sashaml29/arduino-remote-gsm-station/README.md

# arduino-remote-gsm-station

основной модуль построен на Arduino Mega 2560
датчики на основе Arduino Uno, но не плата а чипы AtMega328P 
проект  умеет :

считывать данные с беспроводных датчиков с длительным временем работы

выводить их на дисплей

посылать по команде информацию с датчиков по смс по номеру первой ячейки сим

записывать в первую ячейку мастер номер и в дальнейшем реагировать на команды только с этого номера

на определенные датчики при превышении или уменьшении некого порога посылается смс сообщение

на sd карту должен ведется лог показаний датчиков

датчик - все удаленное устройство целиком, к нему подключены сенсоры (температуры, влажности и т. д.)
датчики имеют номера с 0 до 9 (0 - это головной блок), сенсоры имеют номера с 0 до 9.

команды смс :

#info - краткая информация с датчиков

#inff - полная информация с датчиков -напряжение батареи и время прихода последних данных

#settime -установка текущего времени в модуль часов, время берется автоматически из служебных данных смс

#setmynum -установка мастер номера, с которого будут приниматься команды, с других номеров игнорироваться

#balans посылка текущего балнса

#all - вывести список всех уведомлений

#al*  - удалить все уведомления

#al1* удалить уведомление с заданным номером, где 1 - номер ячейки в массиве уведомлений

#al123u34.50 - в ячейку 1 от датчика 2 , а его сенсора 3 , u -признак того что увкедомление будет послано при превышении порга, d - при понижении порога, 34.50  сам порог срабатывания сенсора,

эти команды могут быть даны с последовательного порта (консоли)

Данные датчиков пишуться в лог с именем файла (номер датчика) и расширением csv и разделителем точка с запятой. 
На каждый датчик два лога 1.csv и t1.csv , в лог 1.csv пишутся данные только при изменнении данных каких либо сенсоров датчика, в t1 - регулярно каждый час.
Вывести лог можно в косоль командой:

log 1 или

log t1 , вместо 1 - номер датчика

dellog 1 удаляет лог файл 1.csv

С консоли можно ввести команду для модема, если команда консоли начинается с AT, то  она будет отправлена в модем, ответ модема будет выведен в консоль. 

команда консоли listmd выводит в консоль основной массив данных датчиков

проект должен еще уметь 

вести системный лог - рестарты, пропадание сигнала с датчиков

выводить на экран несколько страниц показаний, листание- кнопкой

посылать смс при при пропадании питания

посылать смс при перезагрузке, если это была аварийная презагрузка

считывать показания датчиков, подключенных к основной плате

должна быть возможность подключится из интернета по wifi и посмотреть текущие показания

должна быть возможность прочитать лог датчиков с интернета

должна быть возможность включать внешние устройства по команде с смс или по показаниям датчиков

исходный код
https://create.arduino.cc/editor/sasha_ml/d271f25d-d158-4372-87bb-69d778120403/preview

схемы
https://easyeda.com/sasha_ml/Arduino_Mega-15a761a8028f4398b58b41b1c01d44cf
https://easyeda.com/normal/with_sim900-cec6111705ad414b99fb65d70da5dad2
