sashaml29/arduino-remote-gsm-station/rf433modules/Readme.md

В этой папке рабочий проект с приемником с дисплеем 1602 на Ardiuino Uno и передатчиком на atmega328P вставленной в колодку программатора.

В приемнике используется дешевый модуль приемника 433 мгц

В передатчике используются два датчика dht22, 18ds20, пердатчик на батарейках, исрользованы энергосберегающие режимы

схемы
https://easyeda.com/sasha_ml/arduino_with_lcd_and_rfmodule-15622ccd768a4618abc1057a1459d12f

recivtestlowpower.ino	приемник на батарейках, сбор данных с радиомодулей и передача на narodmon через esp8266
