sashaml29/arduino-remote-gsm-station/rf433modules/Reciv.png

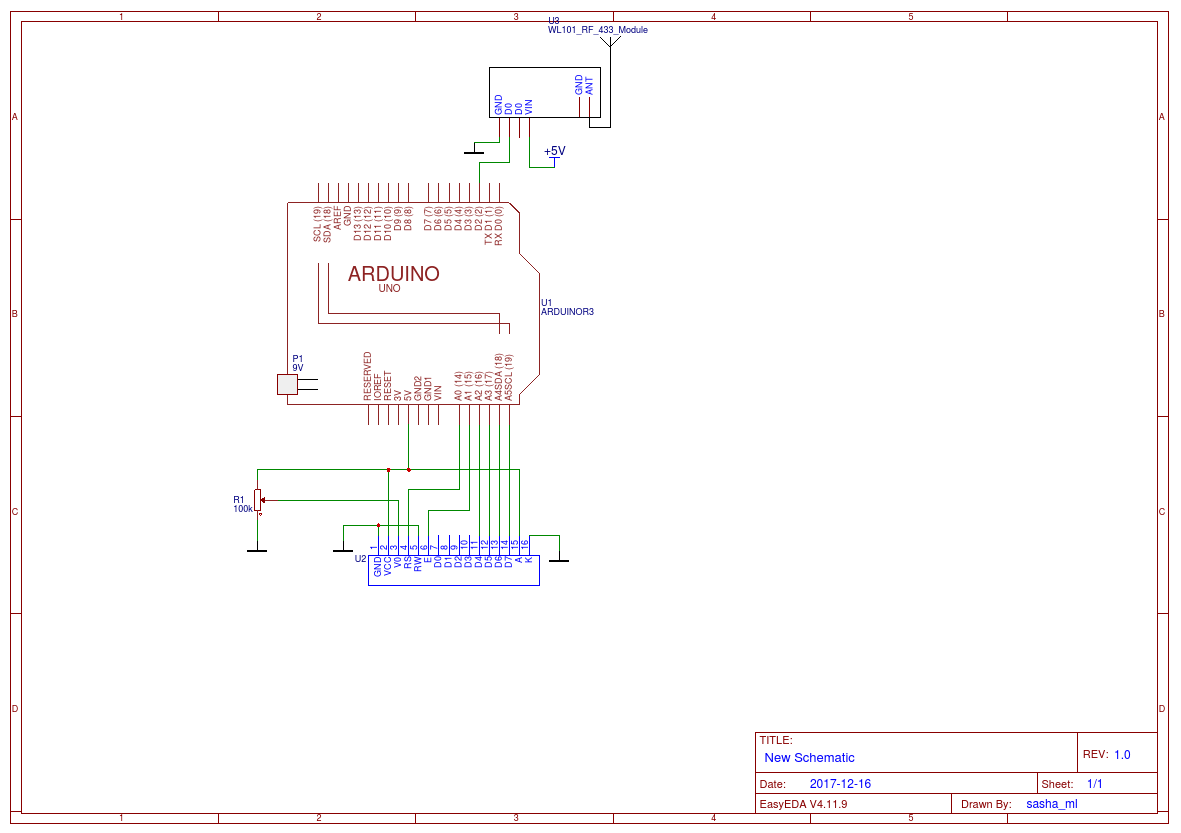
rf433modules/Reciv.png
