sashaml29/arduino-remote-gsm-station/rf433modules/transmitter433.png

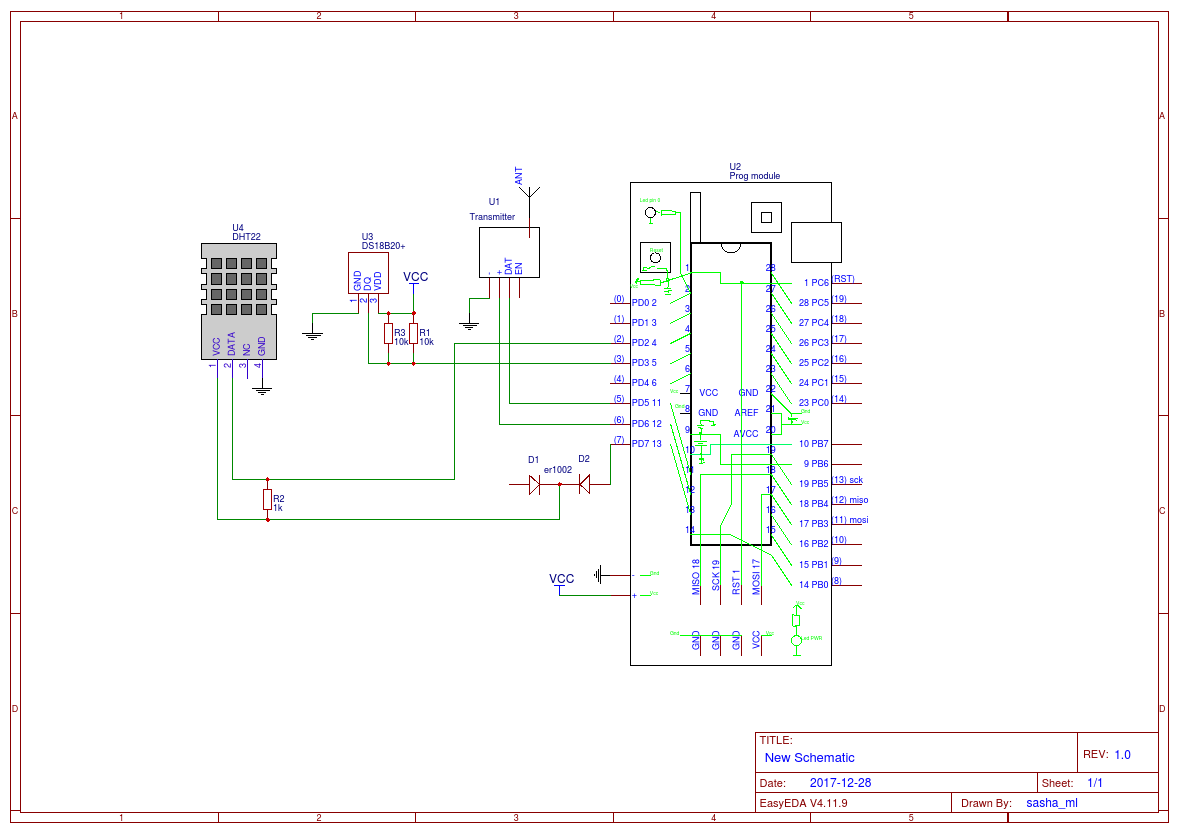
rf433modules/transmitter433.png
