sashaml29/arduino-remote-gsm-station/rf433modules/transmitter.pdf

## VCC

## testmode (if connect to GND)

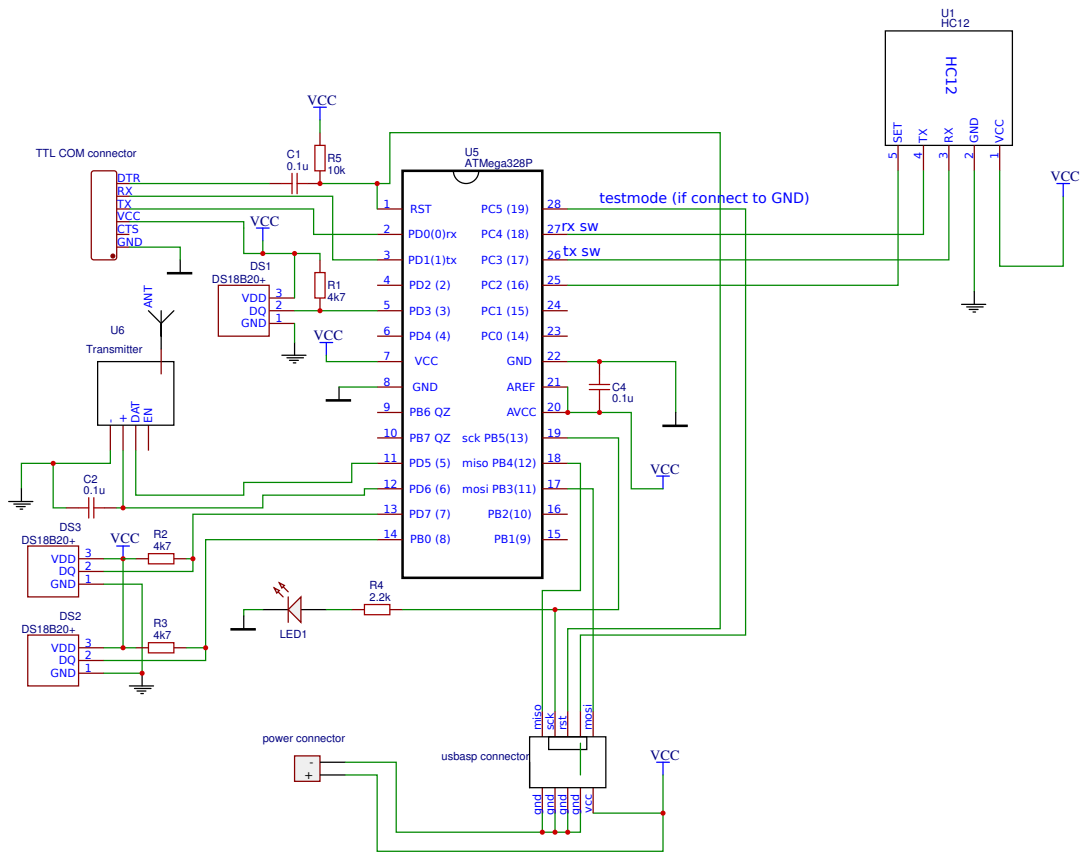
[picture p3: page 1]
