sashaml29/arduino-remote-gsm-station/rf433modules/recivtestlowpower.pdf

## Text

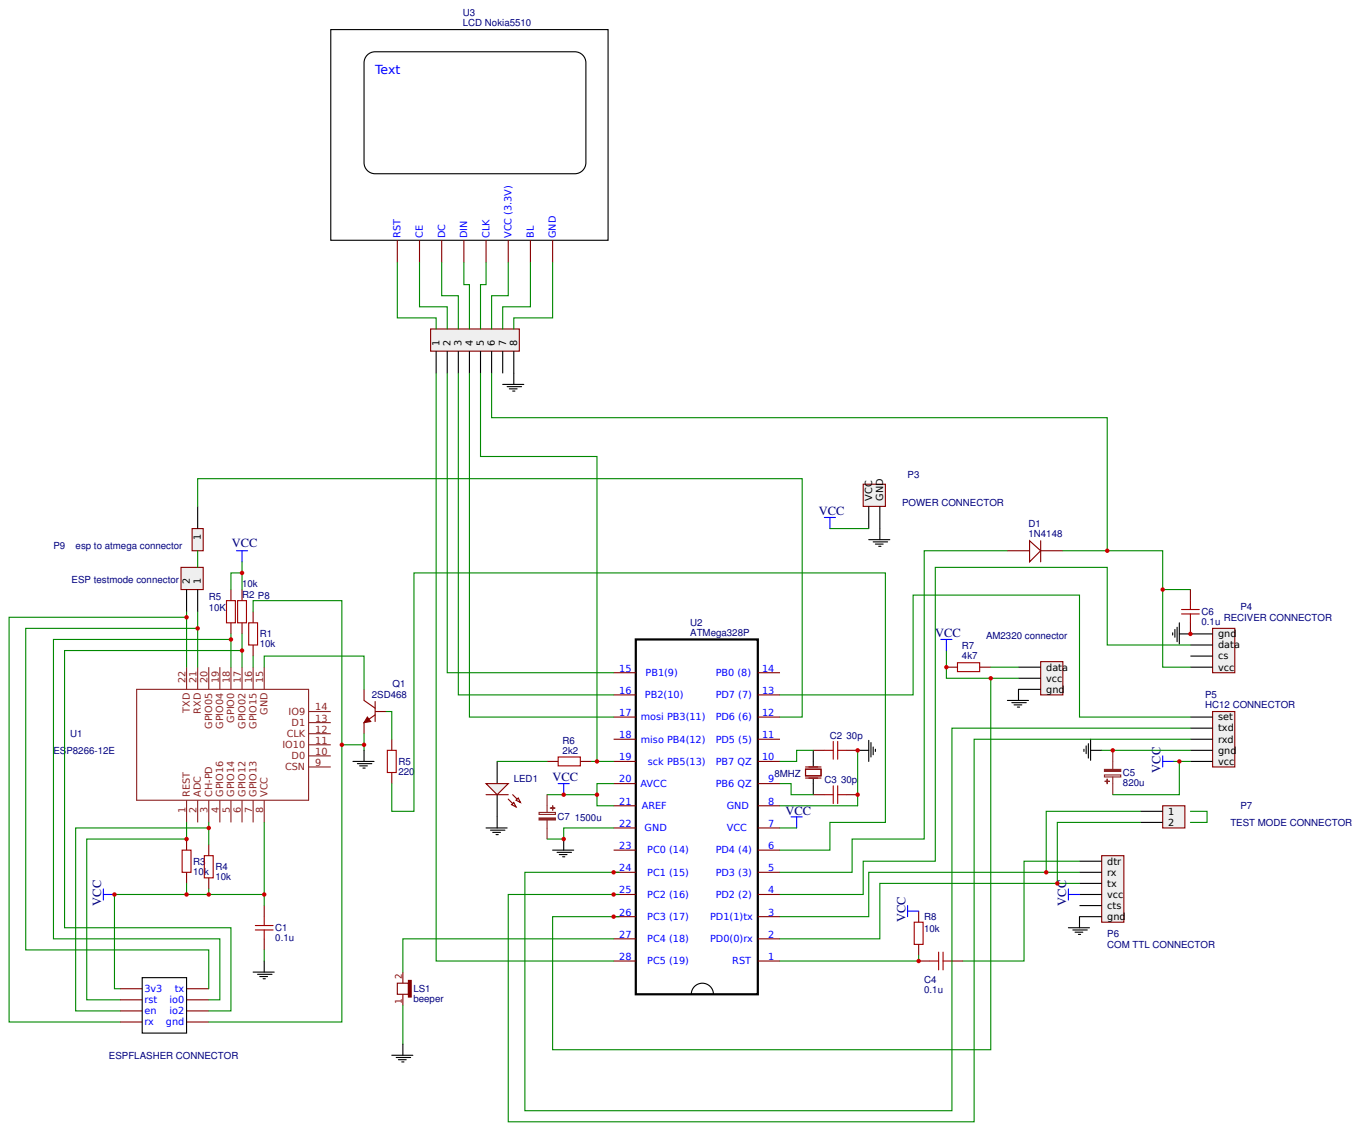
[picture p4: page 1]

P9 esp to atmega connector 1
