sashaml29/arduino-remote-gsm-station/(commit log)

2017-12-17 Create посылка смс
2017-12-17 Update посылка смс
2017-12-20 посылка смс работает
    сменен способ чтения из порта
2017-12-21 добавлена команда посылки баланса и записи мастер номера в первую ячейку сим
    надо сделать чтение из первой ячейки им - это будет мастер номер
2017-12-23 Rename посылка смс to gsm/посылка смс
2017-12-23 Rename посылка смс to работа с смс и sim900
2017-12-23 сделана проверка на чтение мастер номера из первой ячейки симкарты
2017-12-26 работает посылка и прием смс, watchdog, подключен дисплей
2017-12-29 код для передатчика
2017-12-29 код для приемника
2017-12-29 Код приемника
2017-12-29 загружена доругая схема
2017-12-29 Схема передатчика
2017-12-29 Схема приемника
2017-12-29 Схема приемнике
2018-01-04 изменено разрешение термодатчика, вместо символьной строки посылается передатчиком массив байт
2018-01-05 последний вариант с приемником идисплеем на родном spi
2018-01-05 дисплей перенесен на другие пины - нужно освободить SPI
2018-01-07 сделан разбор данных на короткие и длинные посылки и валидность принятых данных
2018-01-07 сделаны короткие и длинные посылки, выделенные отдельные процедуры передачи и чтения
2018-01-08 описан массив основных данных, сделан вывод на дисплей данных температуры
2018-01-08 подключены часы реального времени DS3231
2018-01-09 реализована запись в лог по времени и по изменению температуры
2018-01-11 реализованы уведомления при понижениии или превышении порога датчиков
2018-01-12 сделана команда listmd - вывод в консоль основного массива датчиков
2018-01-27 релиз 1
    посылка каждые 16 сек
2018-01-27 приемник на батарейках и передача на narodmon через esp8266
2018-02-06 работа с hc12
2018-02-06 прием с hc 12
2018-02-06 hc12 и 433 работают вместе на прием
2018-02-06 hc12 отлажено
2018-02-09 последний рабочий релиз с текстовыми строками
    мало памяти для переменных, когда формируется строка strout, память переполняется, идут глюки
2018-02-09 релиз без длинных строк dtrout
    посылка на сервер динамически формируется посылкой в порт esp
2018-02-10 схема приемной станции сбора данных на батарейках
2018-02-15 добавленs типы датчиков dht (am2320)
2018-02-15 исправленная библиотека dht для большего энергосбережения
2018-02-15 испр ошибка
